jboone/nabu-network-adapter/hardware/nabu-na-demod/nabu-na-demod.kicad_sch

## KiCad design hardware/nabu-na-demod/nabu-na-demod.kicad_sch (2024-03-26)

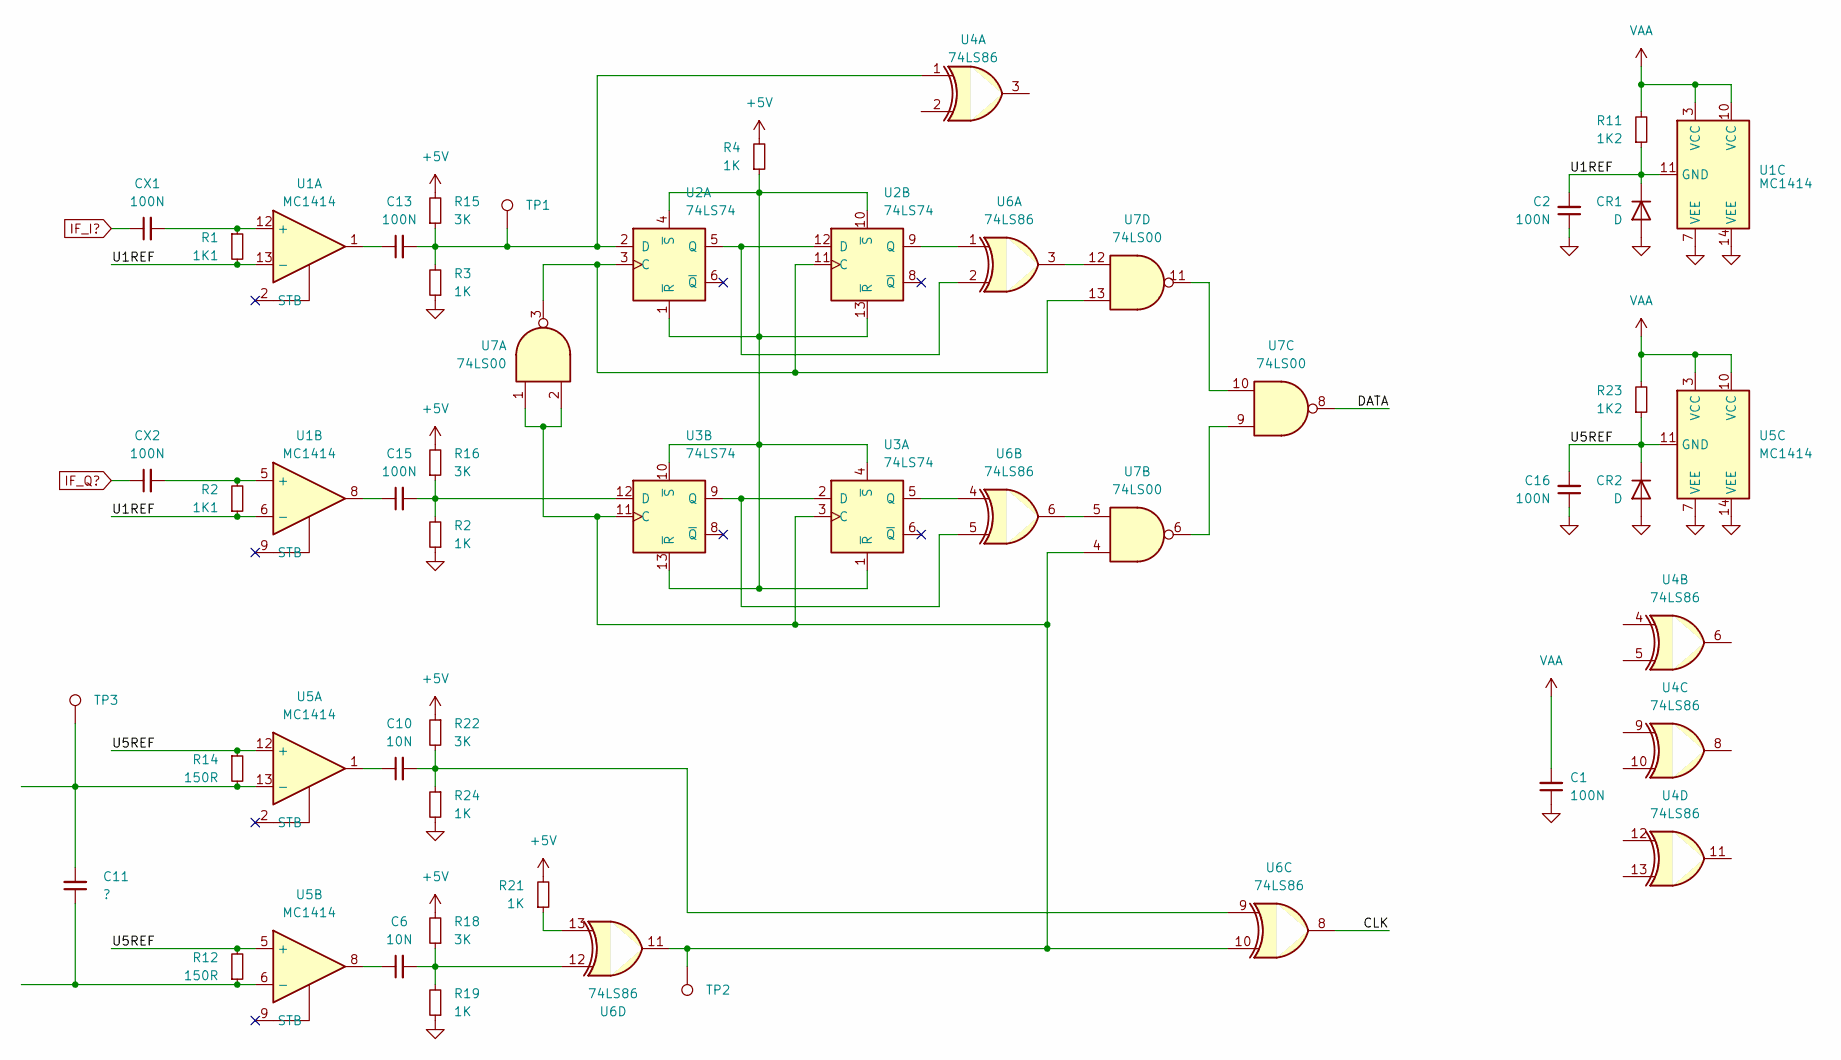
[picture p1: schematic nabu-na-demod.kicad_sch]

Parts:
C1, C2, C13, C15, C16: 100N
C6, C10: 10N
C11: ?
CR1, CR2: D
CX1, CX2: 100N
R1, R2: 1K1
R3, R4, R19, R21, R24: 1K
R11, R23: 1K2
R12, R14: 150R
R15, R16, R18, R22: 3K
TP1, TP2, TP3: TestPoint
U1, U5: MC1414
U2, U3: 74LS74
U4, U6: 74LS86
U7: 74LS00

Connections:
+5V: R4.2, R15.2, R16.2, R18.2, R21.2, R22.1
CLK: U6.8
DATA: U7.8
GND: C1.1, C2.1, C16.1, CR1.2 (A), CR2.2 (A), R2.1, R3.1, R19.1, R24.2, U1.7 (VEE), U1.14 (VEE), U5.7 (VEE), U5.14 (VEE)
IF_I?: CX1.1
IF_Q?: CX2.1
unnamed: C6.1, U5.8
unnamed: C6.2, R18.1, R19.2, U6.12
unnamed: C10.1, U5.1
unnamed: C10.2, R22.2, R24.1, U6.9
unnamed: C11.1, R12.1, U5.6 (-)
unnamed: C11.2, R14.2, TP3.1, U5.13 (-)
unnamed: C13.1, U1.1
unnamed: C13.2, R3.2, R15.1, TP1.1, U2.2 (D), U4.1
unnamed: C15.1, U1.8
unnamed: C15.2, R2.2, R16.1, U3.12 (D)
unnamed: CX1.2, R1.1, U1.12 (+)
unnamed: CX2.2, R2.2, U1.5 (+)
unnamed: R4.1, U2.1 (~R), U2.4 (~S), U2.10 (~S), U2.13 (~R), U3.1 (~R), U3.4 (~S), U3.10 (~S), U3.13 (~R)
unnamed: R21.1, U6.13
unnamed: TP2.1, U3.3 (C), U3.11 (C), U6.10, U6.11, U7.1, U7.2, U7.4
unnamed: U2.9 (Q), U6.1
unnamed: U2.3 (C), U2.11 (C), U7.3, U7.13
unnamed: U2.5 (Q), U2.12 (D), U6.2
unnamed: U3.2 (D), U3.9 (Q), U6.5
unnamed: U3.5 (Q), U6.4
unnamed: U6.3, U7.12
unnamed: U6.6, U7.5
unnamed: U7.6, U7.9
unnamed: U7.10, U7.11
U1REF: C2.2, CR1.1 (K), R1.2, R2.1, R11.1, U1.6 (-), U1.11 (GND), U1.13 (-)
U5REF: C16.2, CR2.1 (K), R12.2, R14.1, R23.1, U5.5 (+), U5.11 (GND), U5.12 (+)
VAA: C1.2, R11.2, R23.2, U1.3 (VCC), U1.10 (VCC), U5.3 (VCC), U5.10 (VCC)
