jboone/nabu-network-adapter/hardware/nabu-na-logic/descrambler.kicad_sch

## KiCad design hardware/nabu-na-logic/descrambler.kicad_sch (2024-03-25)

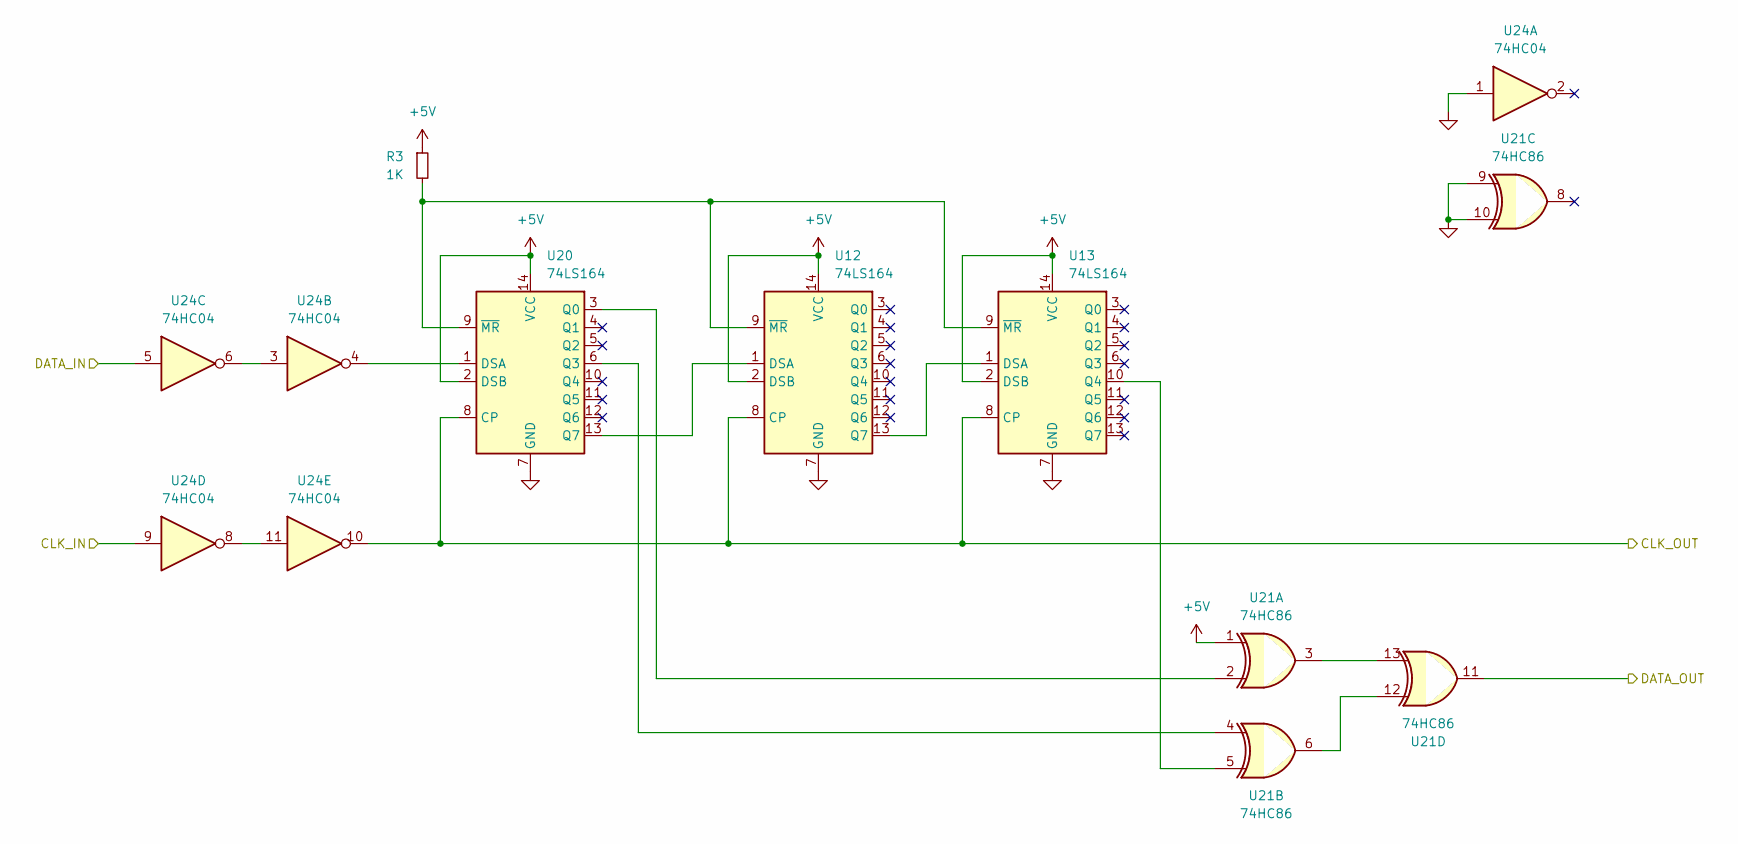
[picture p2: schematic descrambler.kicad_sch]

Parts:
R3: 1K
U12, U13, U20: 74LS164
U21: 74HC86
U24: 74HC04

Connections:
+5V: R3.1, U12.2 (DSB), U12.14 (VCC), U13.2 (DSB), U13.14 (VCC), U20.2 (DSB), U20.14 (VCC), U21.1
CLK_IN: U24.9
CLK_OUT: U12.8 (CP), U13.8 (CP), U20.8 (CP), U24.10
DATA_IN: U24.5
DATA_OUT: U21.11
GND: U12.7 (GND), U13.7 (GND), U20.7 (GND), U21.9, U21.10, U24.1
unnamed: R3.2, U12.9 (~MR), U13.9 (~MR), U20.9 (~MR)
unnamed: U12.1 (DSA), U20.13 (Q7)
unnamed: U12.13 (Q7), U13.1 (DSA)
unnamed: U13.10 (Q4), U21.5
unnamed: U20.1 (DSA), U24.4
unnamed: U20.3 (Q0), U21.2
unnamed: U20.6 (Q3), U21.4
unnamed: U21.6, U21.12
unnamed: U21.3, U21.13
unnamed: U24.3, U24.6
unnamed: U24.8, U24.11
