jboone/nabu-network-adapter/hardware/nabu-na-logic/nabu-na-logic.kicad_sch

## KiCad design hardware/nabu-na-logic/nabu-na-logic.kicad_sch (2024-03-26)

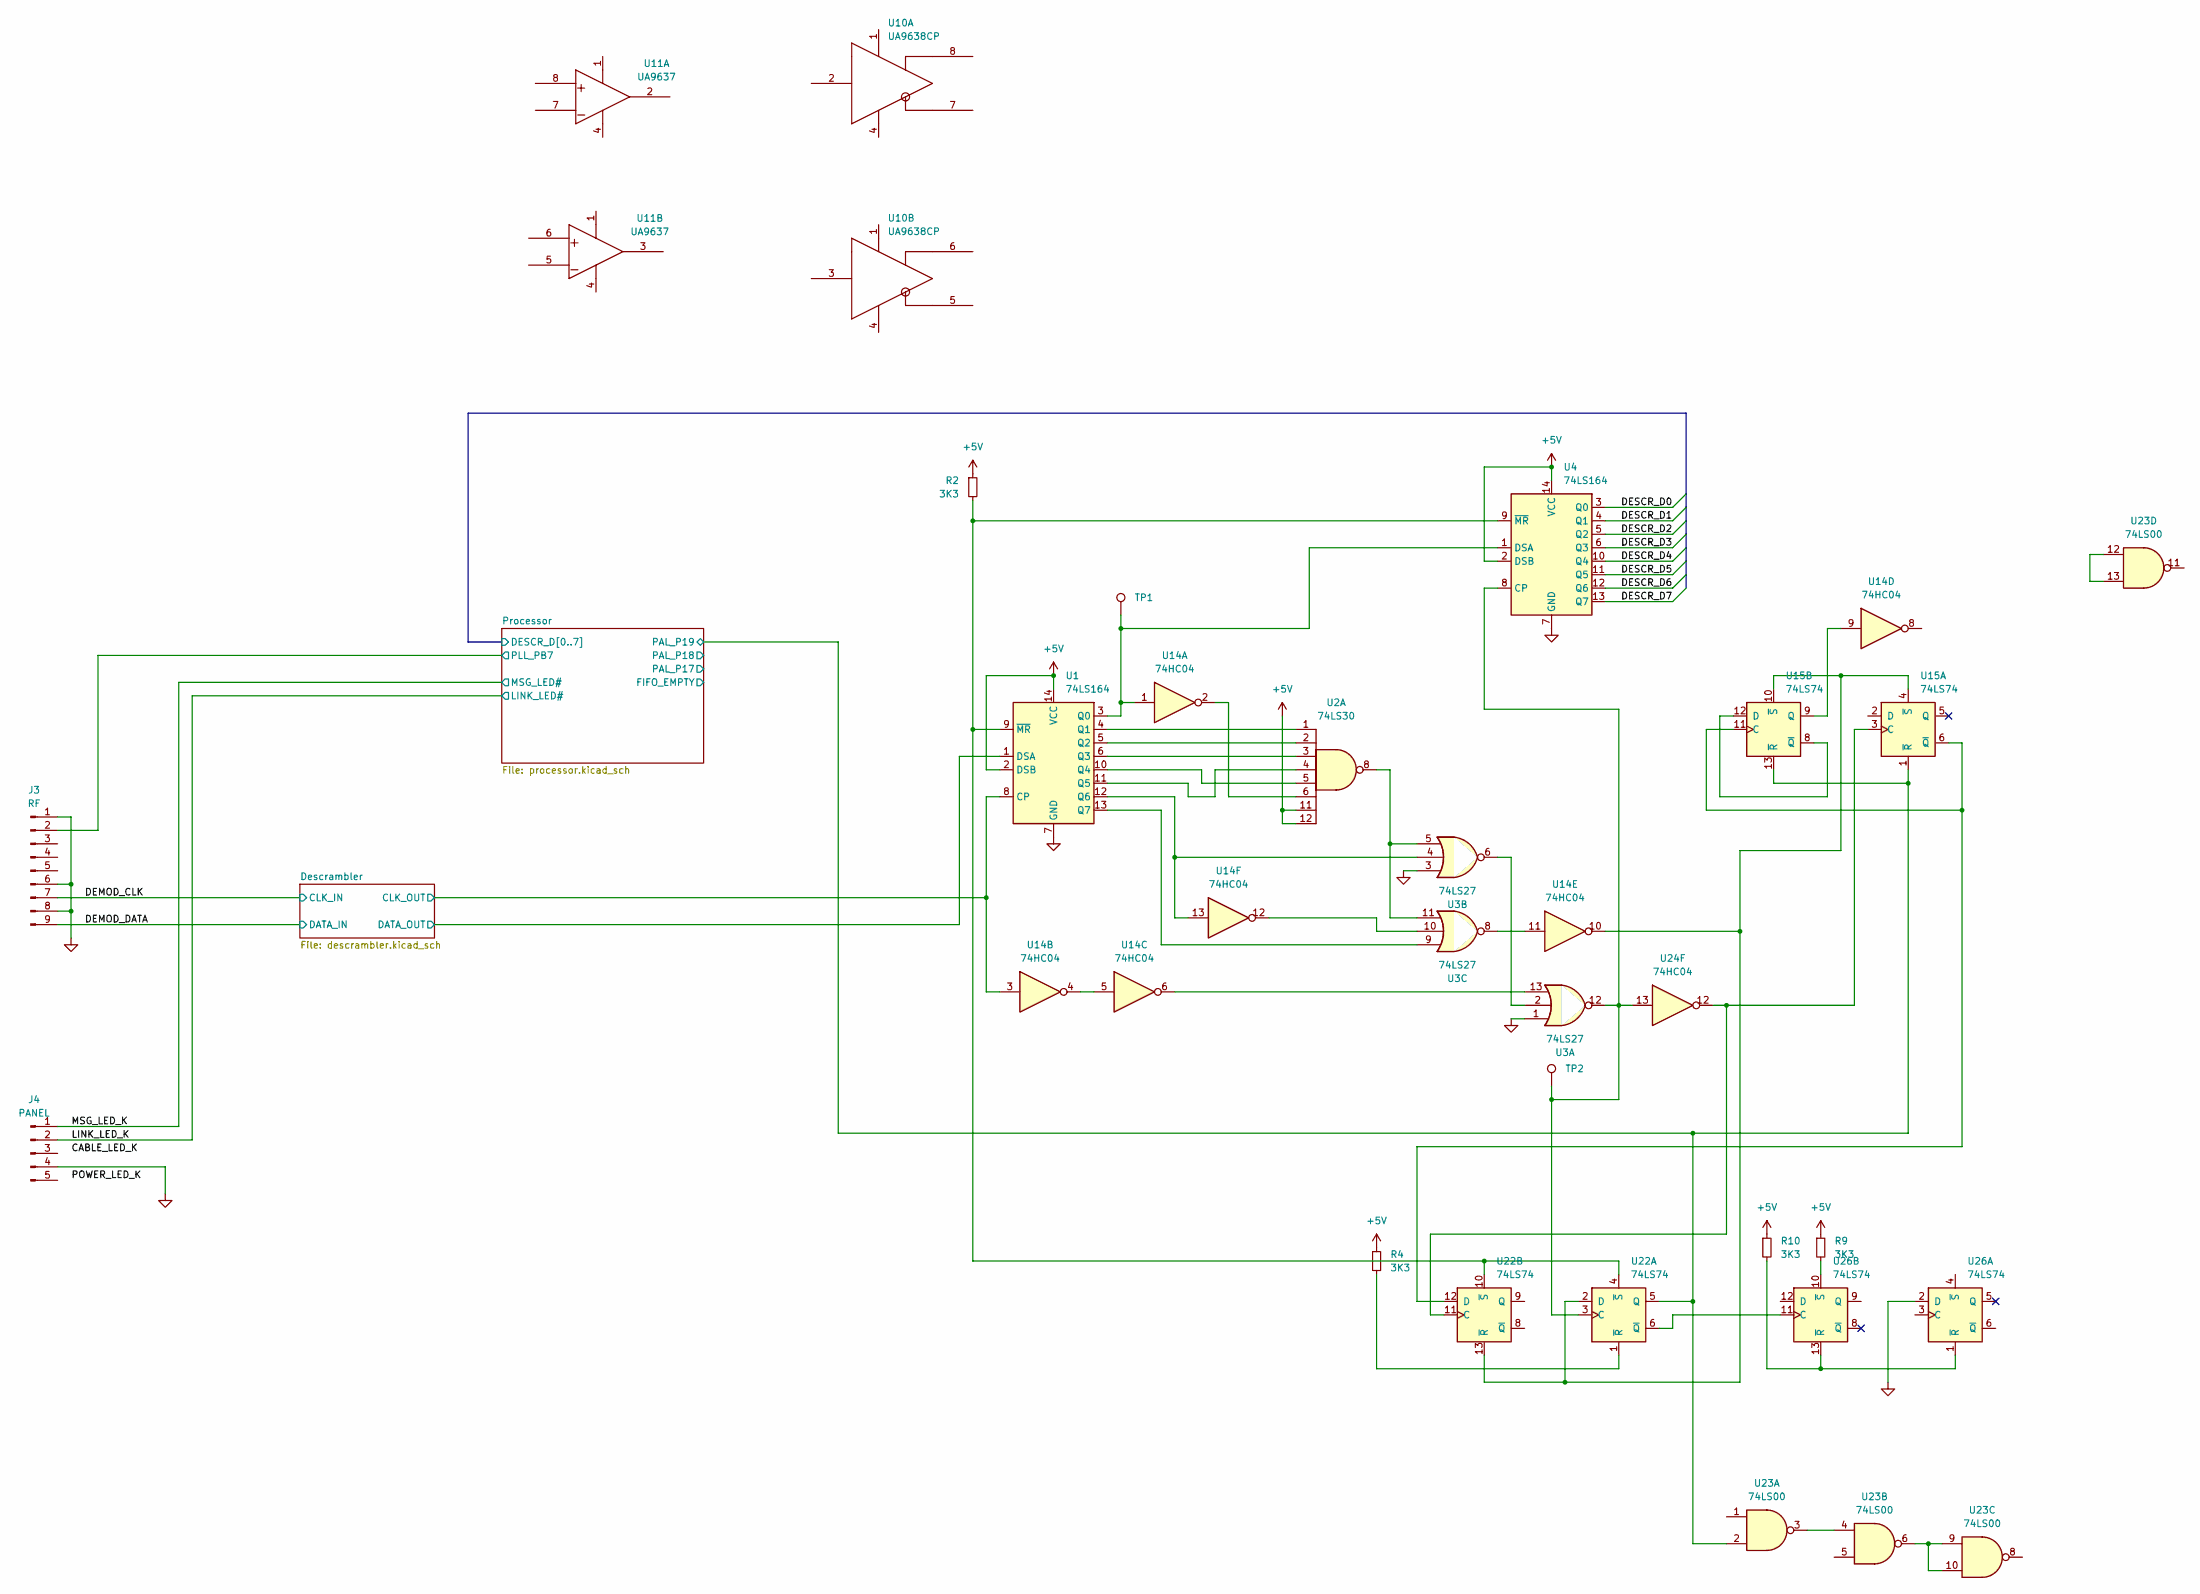
[picture p3: schematic nabu-na-logic.kicad_sch]

Parts:
J3: RF
J4: PANEL
R2, R4, R9, R10: 3K3
TP1, TP2: TestPoint
U1, U4: 74LS164
U2: 74LS30
U3: 74LS27
U10: UA9638CP; DIP-8_W7.62mm
U11: UA9637; DIP-8_W7.62mm
U14, U24: 74HC04
U15, U22, U26: 74LS74
U23: 74LS00

Connections:
+5V: R2.1, R4.1, R9.1, R10.1, U1.2 (DSB), U1.14 (VCC), U2.11, U2.12, U4.2 (DSB), U4.14 (VCC)
CLK_OUT: U1.8 (CP), U14.3
DATA_OUT: U1.1 (DSA)
DEMOD_CLK: J3.7
DEMOD_DATA: J3.9
DESCR_D0: U4.3 (Q0)
DESCR_D1: U4.4 (Q1)
DESCR_D2: U4.5 (Q2)
DESCR_D3: U4.6 (Q3)
DESCR_D4: U4.10 (Q4)
DESCR_D5: U4.11 (Q5)
DESCR_D6: U4.12 (Q6)
DESCR_D7: U4.13 (Q7)
GND: J3.1, J3.6, J3.8, J4.4, U1.7 (GND), U3.1, U3.3, U4.7 (GND), U26.2 (D)
LINK_LED_K: J4.2
MSG_LED_K: J4.1
unnamed: R2.2, U1.9 (~MR), U4.9 (~MR), U22.4 (~S), U22.10 (~S)
unnamed: R4.2, U22.1 (~R)
unnamed: R9.2, U26.10 (~S)
unnamed: R10.2, U26.1 (~R), U26.13 (~R)
unnamed: TP1.1, U1.3 (Q0), U4.1 (DSA), U14.1
unnamed: TP2.1, U3.12, U4.8 (CP), U22.3 (C), U24.13
unnamed: U1.4 (Q1), U2.1
unnamed: U1.5 (Q2), U2.2
unnamed: U1.6 (Q3), U2.3
unnamed: U1.10 (Q4), U2.5
unnamed: U1.11 (Q5), U2.4
unnamed: U1.12 (Q6), U3.4, U14.13
unnamed: U1.13 (Q7), U3.9
unnamed: U2.8, U3.5, U3.11
unnamed: U3.2, U3.6
unnamed: U2.6, U14.2
unnamed: U14.4, U14.5
unnamed: U3.13, U14.6
unnamed: U14.9, U15.9 (Q)
unnamed: U14.10, U15.4 (~S), U15.10 (~S), U22.2 (D), U22.13 (~R)
unnamed: U3.8, U14.11
unnamed: U3.10, U14.12
unnamed: U15.3 (C), U22.11 (C), U24.12
unnamed: U15.6 (~Q), U15.11 (C), U22.12 (D)
unnamed: U15.8 (~Q), U15.12 (D)
unnamed: U22.6 (~Q), U26.11 (C)
unnamed: U23.3, U23.4
unnamed: U23.6, U23.9, U23.10
unnamed: U23.12, U23.13
PAL_P19: U15.1 (~R), U15.13 (~R), U22.5 (Q), U23.2
PLL_PB7: J3.2
