jboone/nabu-network-adapter/hardware/nabu-na-logic/processor.kicad_sch

## KiCad design hardware/nabu-na-logic/processor.kicad_sch (2024-03-26)

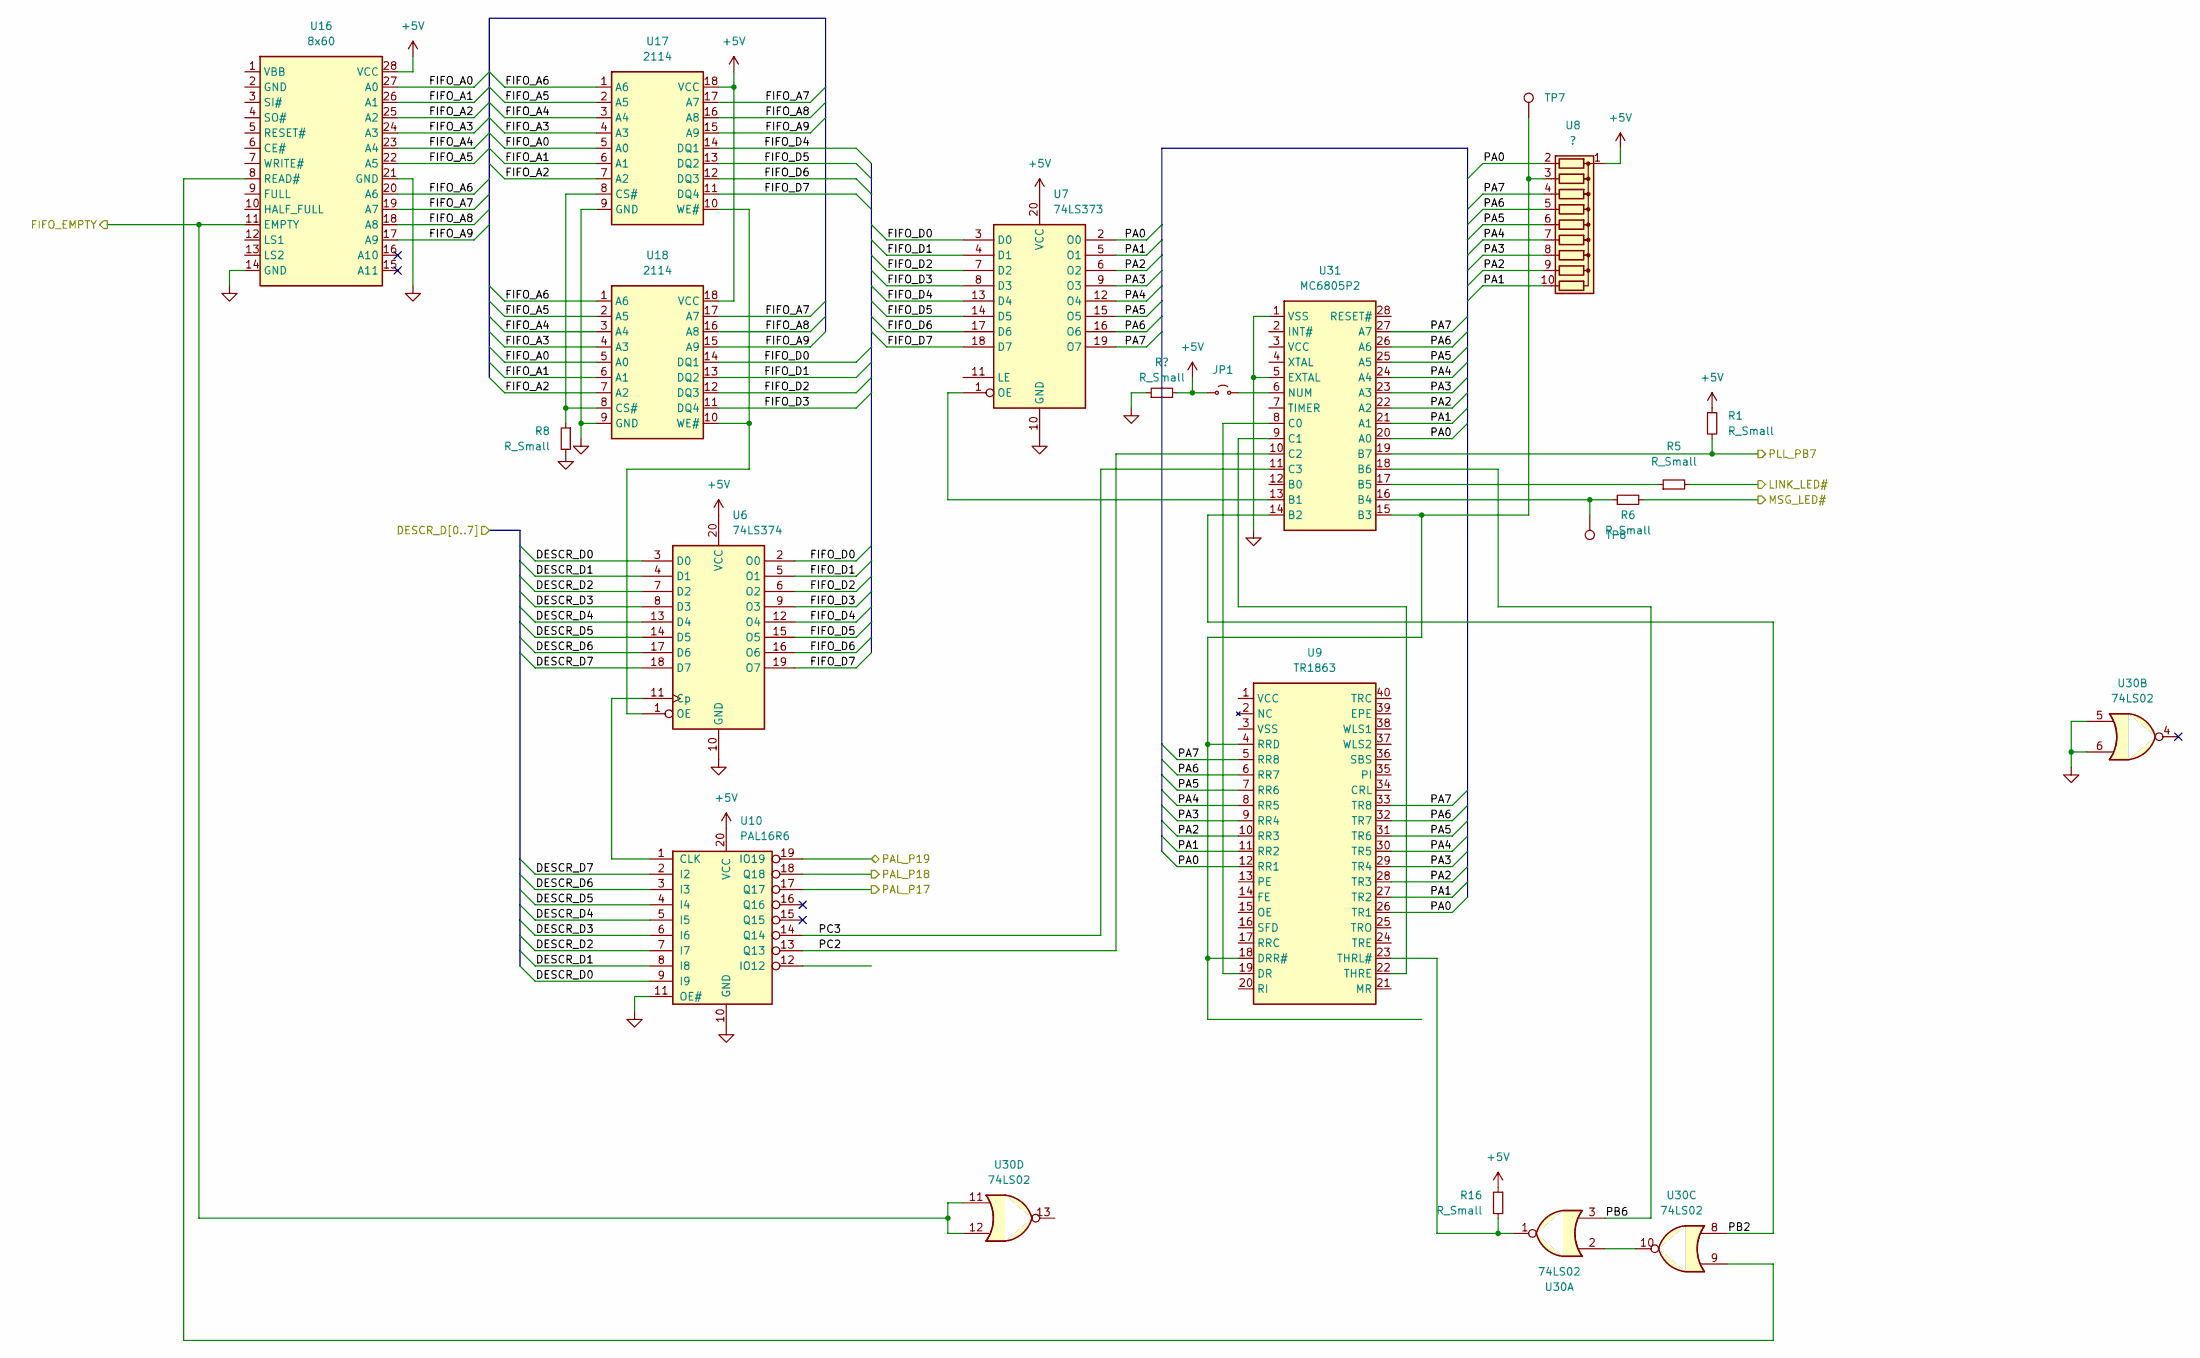
[picture p4: schematic processor.kicad_sch]

Parts:
JP1: Jumper_2_Small_Bridged
R1, R5, R6, R8, R16: R_Small
TP7, TP8: TestPoint
U6: 74LS374
U7: 74LS373
U8: ?; R_Array_SIP10
U9: TR1863
U10: PAL16R6
U16: 8x60
U17, U18: 2114
U30: 74LS02
U31: MC6805P2

Connections:
+5V: JP1.1 (A), R1.1, R16.1, U6.20 (VCC), U7.20 (VCC), U8.1 (common), U10.20 (VCC), U16.28 (VCC), U17.18 (VCC), U18.18 (VCC)
DESCR_D0: U6.3 (D0), U10.9 (I9)
DESCR_D1: U6.4 (D1), U10.8 (I8)
DESCR_D2: U6.7 (D2), U10.7 (I7)
DESCR_D3: U6.8 (D3), U10.6 (I6)
DESCR_D4: U6.13 (D4), U10.5 (I5)
DESCR_D5: U6.14 (D5), U10.4 (I4)
DESCR_D6: U6.17 (D6), U10.3 (I3)
DESCR_D7: U6.18 (D7), U10.2 (I2)
FIFO_A0: U16.27 (A0), U17.5 (A0), U18.5 (A0)
FIFO_A1: U16.26 (A1), U17.6 (A1), U18.6 (A1)
FIFO_A2: U16.25 (A2), U17.7 (A2), U18.7 (A2)
FIFO_A3: U16.24 (A3), U17.4 (A3), U18.4 (A3)
FIFO_A4: U16.23 (A4), U17.3 (A4), U18.3 (A4)
FIFO_A5: U16.22 (A5), U17.2 (A5), U18.2 (A5)
FIFO_A6: U16.20 (A6), U17.1 (A6), U18.1 (A6)
FIFO_A7: U16.19 (A7), U17.17 (A7), U18.17 (A7)
FIFO_A8: U16.18 (A8), U17.16 (A8), U18.16 (A8)
FIFO_A9: U16.17 (A9), U17.15 (A9), U18.15 (A9)
FIFO_D0: U6.2 (O0), U7.3 (D0), U18.14 (DQ1)
FIFO_D1: U6.5 (O1), U7.4 (D1), U18.13 (DQ2)
FIFO_D2: U6.6 (O2), U7.7 (D2), U18.12 (DQ3)
FIFO_D3: U6.9 (O3), U7.8 (D3), U18.11 (DQ4)
FIFO_D4: U6.12 (O4), U7.13 (D4), U17.14 (DQ1)
FIFO_D5: U6.15 (O5), U7.14 (D5), U17.13 (DQ2)
FIFO_D6: U6.16 (O6), U7.17 (D6), U17.12 (DQ3)
FIFO_D7: U6.19 (O7), U7.18 (D7), U17.11 (DQ4)
FIFO_EMPTY: U16.11 (EMPTY), U30.11, U30.12
GND: R8.2, U6.10 (GND), U7.10 (GND), U10.10 (GND), U10.11 (OE#), U16.14 (GND), U16.21 (GND), U17.9 (GND), U18.9 (GND), U30.5, U30.6, U31.1 (VSS), U31.5 (EXTAL)
LINK_LED#: R5.2
MSG_LED#: R6.2
unnamed: JP1.2 (B), U31.6 (NUM)
unnamed: R5.1, U31.17 (B5)
unnamed: R6.1, TP8.1, U31.16 (B4)
unnamed: R8.1, U17.8 (CS#), U18.8 (CS#)
unnamed: R16.2, U9.23 (THRL#), U30.1
unnamed: TP7.1, U8.3 (R2), U9.4 (RRD), U9.18 (DRR#), U31.15 (B3)
unnamed: U6.11 (Cp), U10.1 (CLK)
unnamed: U16.8 (READ#), U30.9
unnamed: U6.1 (OE), U17.10 (WE#), U18.10 (WE#)
unnamed: U30.2, U30.10
unnamed: U9.19 (DR), U31.8 (C0)
unnamed: U9.22 (THRE), U31.9 (C1)
unnamed: U7.1 (OE), U31.13 (B1)
PA0: U7.2 (O0), U8.2 (R1), U9.12 (RR1), U9.26 (TR1), U31.20 (A0)
PA1: U7.5 (O1), U8.10 (R9), U9.11 (RR2), U9.27 (TR2), U31.21 (A1)
PA2: U7.6 (O2), U8.9 (R8), U9.10 (RR3), U9.28 (TR3), U31.22 (A2)
PA3: U7.9 (O3), U8.8 (R7), U9.9 (RR4), U9.29 (TR4), U31.23 (A3)
PA4: U7.12 (O4), U8.7 (R6), U9.8 (RR5), U9.30 (TR5), U31.24 (A4)
PA5: U7.15 (O5), U8.6 (R5), U9.7 (RR6), U9.31 (TR6), U31.25 (A5)
PA6: U7.16 (O6), U8.5 (R4), U9.6 (RR7), U9.32 (TR7), U31.26 (A6)
PA7: U7.19 (O7), U8.4 (R3), U9.5 (RR8), U9.33 (TR8), U31.27 (A7)
PAL_P17: U10.17 (Q17)
PAL_P18: U10.18 (Q18)
PAL_P19: U10.19 (IO19)
PB2: U30.8, U31.14 (B2)
PB6: U30.3, U31.18 (B6)
PC2: U10.13 (Q13), U31.10 (C2)
PC3: U10.14 (Q14), U31.11 (C3)
PLL_PB7: R1.2, U31.19 (B7)
