jboone/nabu-network-adapter/(commit log)

2024-03-24 Add initial, incomplete schematics for logic and demodulator boards
    [nabu-na-demod.kicad_sch, nabu-na-logic.kicad_sch]
2024-03-24 Add some descrambler details, note to fill out basics of logic board
2024-03-25 Initial, partial work on processor and surroundings, move descrambler to separate sheet
    [descrambler.kicad_sch, nabu-na-logic.kicad_sch, processor.kicad_sch]
2024-03-26 Clean up demodulator schematic -- still incomplete!
    [nabu-na-demod.kicad_sch]
2024-03-26 Ignore some KiCAD droppings.
2024-03-26 Logic board schematic: Add PAL, assorted changes I've forgotten already.
    [nabu-na-logic.kicad_sch, processor.kicad_sch]
2024-03-26 Logic board J3 (RF can) pinout
2024-03-26 More first conversion PLL math, validates EMI probe observations.
2024-03-27 Add gr-nabu GNU Radio module, containing C++ blocks
    This may soon also contain the stand-alone GRC flowgraphs.
2024-03-27 GNU Radio Companion flowgraphs for modulation, and some validation tests
2024-03-28 Power supply details, and a few little RF can bits.
