jboone/nabu-network-adapter/(notices)

Notices in the files:
hardware/nabu-na-logic/nabu-na-logic.kicad_sch:
Copyright (C) 2024 Jared Boone
Open-source licensed under CERN-OHL-P-2.0
